3DAixperts/skirt-button-pcb/V1/images/Skirt Button PCB Back.png

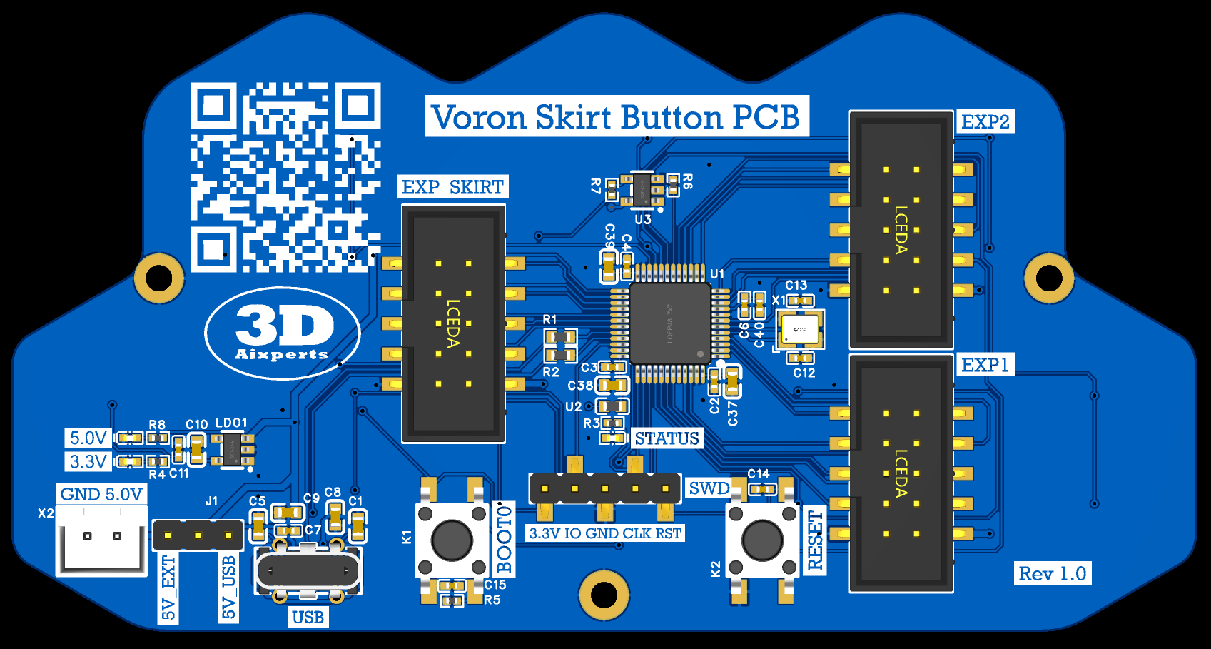
V1/images/Skirt Button PCB Back.png
