3DAixperts/skirt-button-pcb/V1/images/Skirt Button PCB Front.png

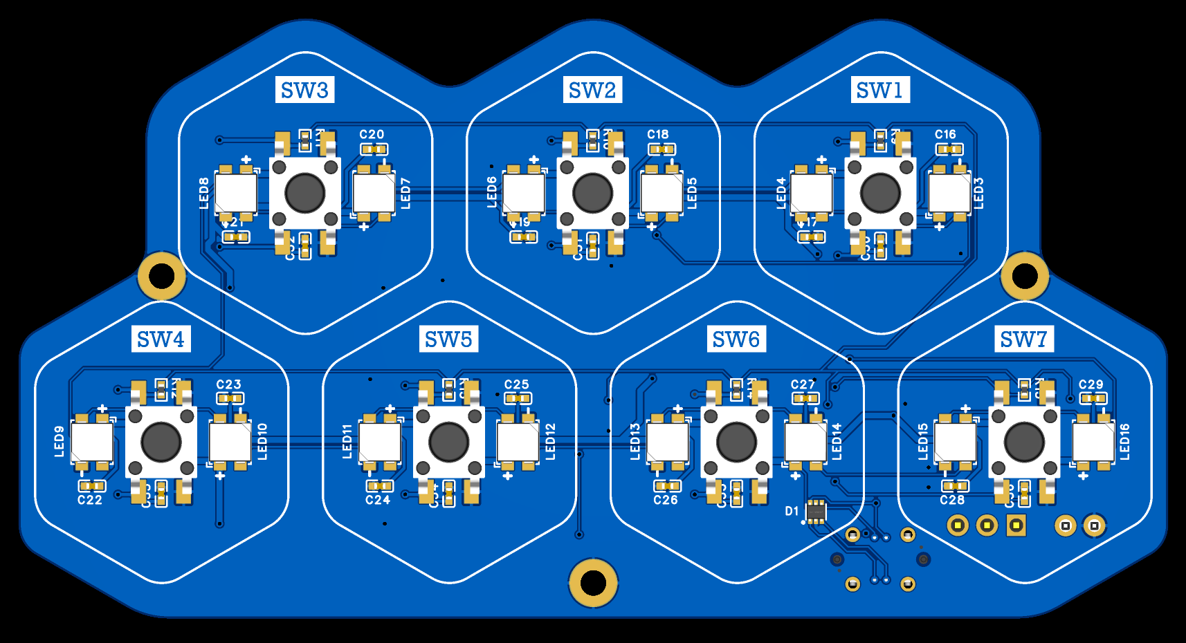
V1/images/Skirt Button PCB Front.png
