3DAixperts/skirt-button-pcb/3D/Skirt_Button_PCB_only_PCB.STEP

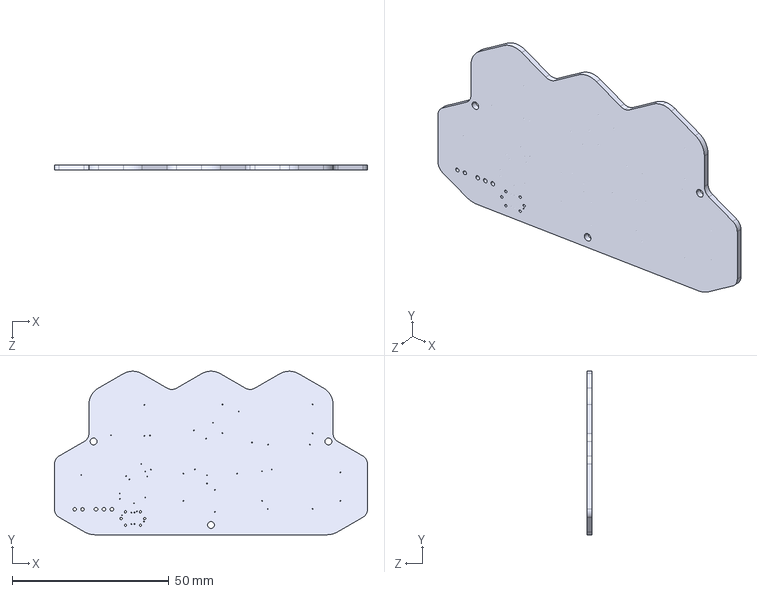
[picture p6: CAD file, 2023-06-12]
3D/Skirt_Button_PCB_only_PCB.STEP
100.0 x 52.3 x 1.60 mm
