3DAixperts/skirt-button-pcb/STEPs/Buttons/regular/single_button_blank.STEP

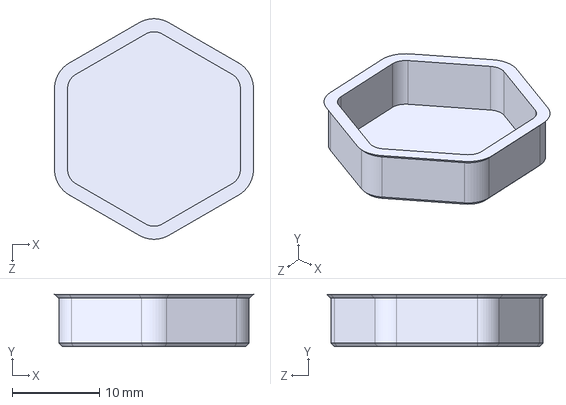
[picture p7: CAD file, 2023-05-26]
STEPs/Buttons/regular/single_button_blank.STEP
22.8 x 6.00 x 25.3 mm
