3DAixperts/skirt-button-pcb/STEPs/Buttons/Trident 250 outer small/button_load_small_250.STEP

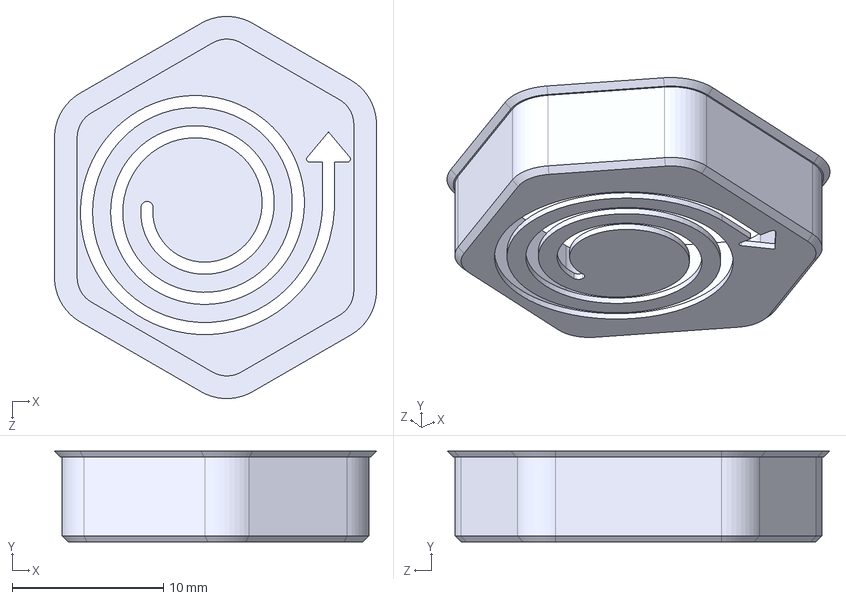
[picture p8: CAD file, 2023-03-20]
STEPs/Buttons/Trident 250 outer small/button_load_small_250.STEP
21.3 x 6.00 x 25.3 mm
