3DAixperts/skirt-button-pcb/STEPs/Trident - Switchwire/250/Left_Front_Skirt_250_Trident_Button_PCB.STEP

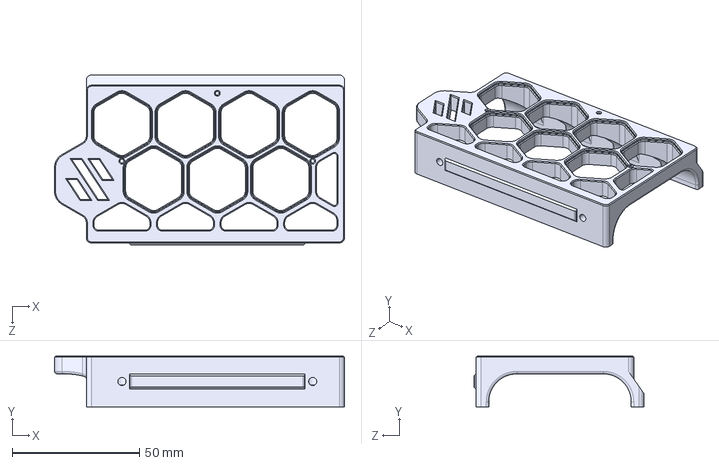
[picture p9: CAD file, 2023-01-08]
STEPs/Trident - Switchwire/250/Left_Front_Skirt_250_Trident_Button_PCB.STEP
114.0 x 20.0 x 66.8 mm
