3DAixperts/skirt-button-pcb/STEPs/Trident - Switchwire/300/Left_Front_Skirt_300_Trident_Button_PCB.STEP

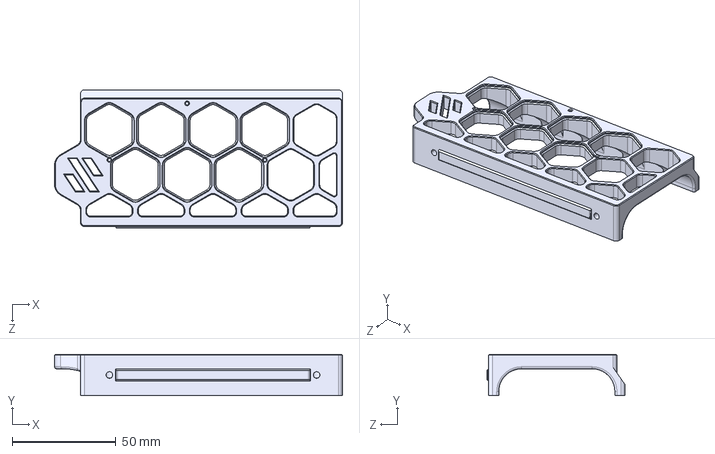
[picture p10: CAD file, 2023-01-08]
STEPs/Trident - Switchwire/300/Left_Front_Skirt_300_Trident_Button_PCB.STEP
139.0 x 20.0 x 66.8 mm
