3DAixperts/skirt-button-pcb/STEPs/Trident - Switchwire/350/Left_Front_Skirt_350_Trident_Button_PCB.STEP

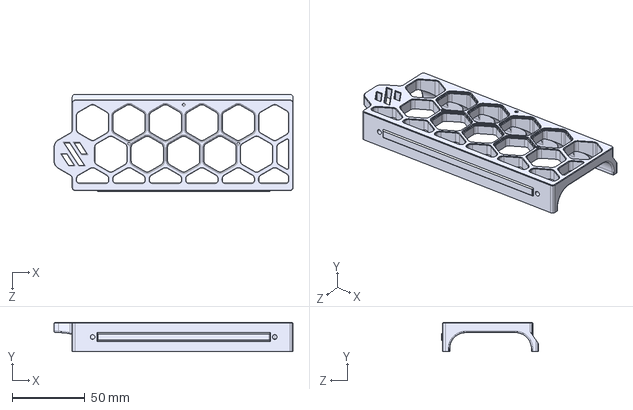
[picture p11: CAD file, 2023-01-08]
STEPs/Trident - Switchwire/350/Left_Front_Skirt_350_Trident_Button_PCB.STEP
164.0 x 20.0 x 66.8 mm
