3DAixperts/skirt-button-pcb/STEPs/V2.4/250/front_skirt_right_250_v2.4_button_PCB.STEP

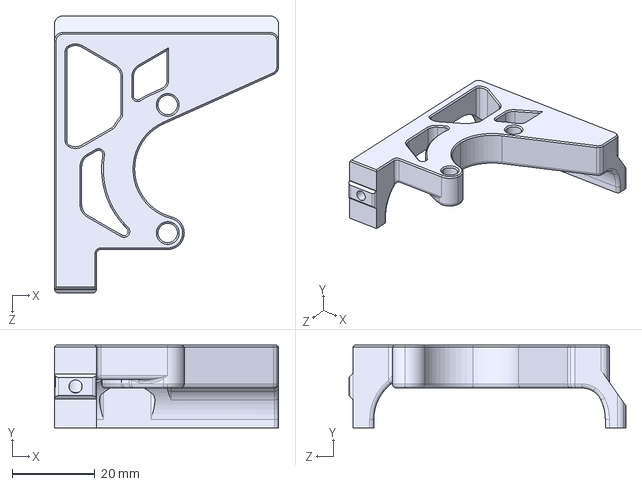
[picture p12: CAD file, 2023-01-08]
STEPs/V2.4/250/front_skirt_right_250_v2.4_button_PCB.STEP
54.2 x 20.0 x 67.0 mm
