3DAixperts/skirt-button-pcb/STEPs/V2.4/300/front_skirt_right_300_v2.4_button_PCB.STEP

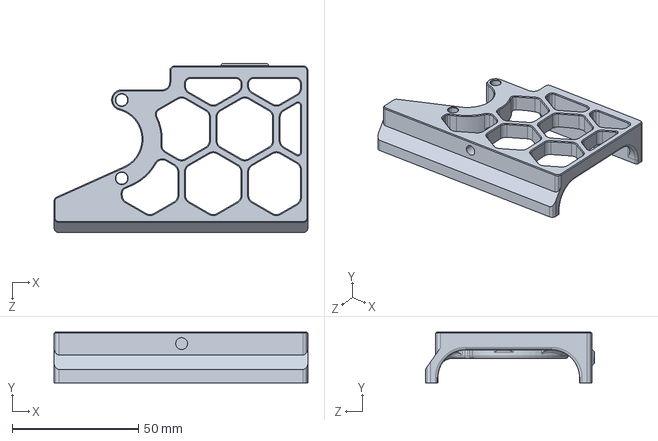
[picture p13: CAD file, 2023-01-08]
STEPs/V2.4/300/front_skirt_right_300_v2.4_button_PCB.STEP
100.5 x 20.0 x 67.0 mm
