3DAixperts/skirt-button-pcb/STEPs/V2.4/350/front_skirt_left_350_v2.4_button_PCB.STEP

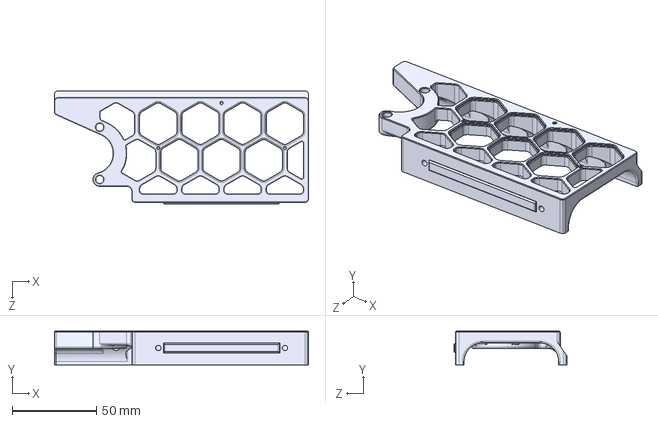
[picture p14: CAD file, 2023-01-08]
STEPs/V2.4/350/front_skirt_left_350_v2.4_button_PCB.STEP
150.5 x 20.0 x 67.0 mm
