3DAixperts/skirt-button-pcb/STEPs/Buttons/regular/button_diffusor.STEP

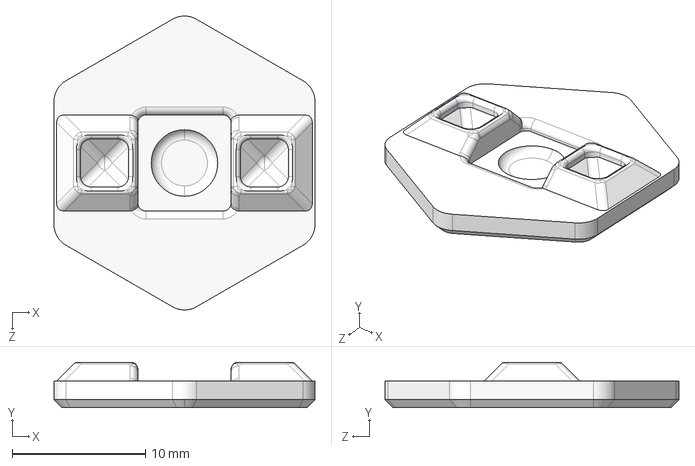
[picture p15: CAD file, 2023-01-29]
STEPs/Buttons/regular/button_diffusor.STEP
19.6 x 3.40 x 22.1 mm
