3DAixperts/skirt-button-pcb/STEPs/Buttons/regular/buttons.STEP

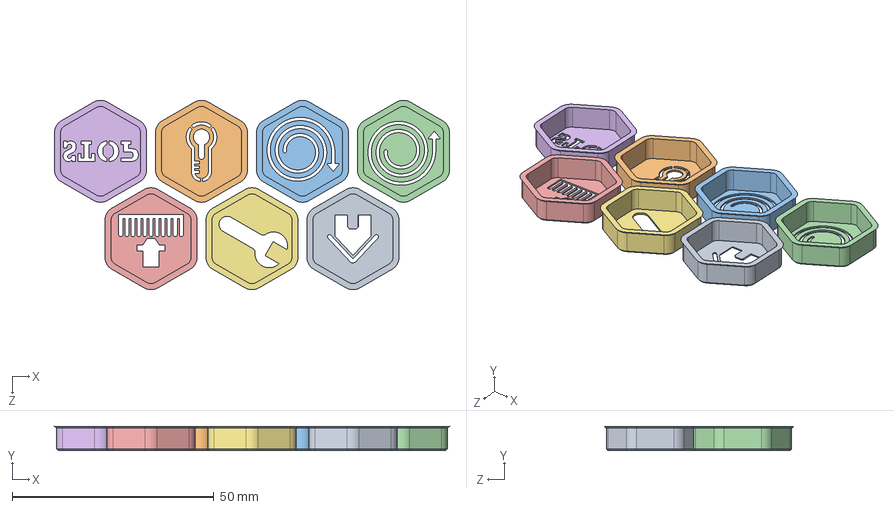
[picture p17: CAD file, 2023-01-08]
STEPs/Buttons/regular/buttons.STEP
97.8 x 6.00 x 46.9 mm
