3DAixperts/skirt-button-pcb/STEPs/Buttons/Trident 250 outer small/diffusor_small_250.STEP

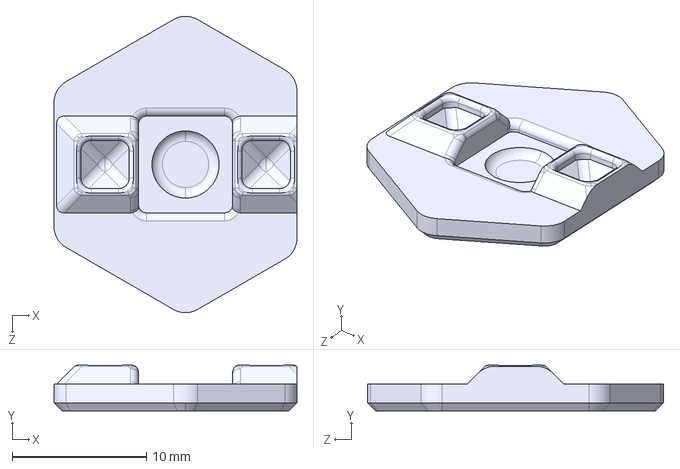
[picture p18: CAD file, 2023-03-19]
STEPs/Buttons/Trident 250 outer small/diffusor_small_250.STEP
18.1 x 3.40 x 22.1 mm
