3DAixperts/skirt-button-pcb/STEPs/V2.0/300/v2.0_skirt_right_300_button_PCB.STEP

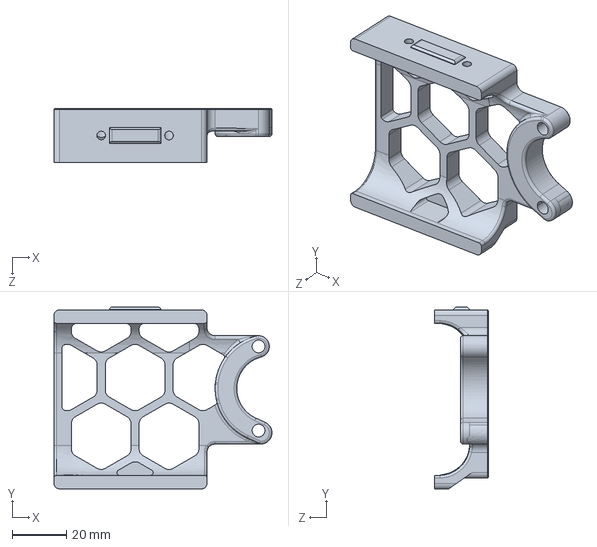
[picture p19: CAD file, 2023-01-20, an earlier design]
STEPs/V2.0/300/v2.0_skirt_right_300_button_PCB.STEP
80.4 x 67.0 x 20.0 mm
