3DAixperts/skirt-button-pcb/STEPs/V2.0/300/v2.0_skirt_left_300_button_PCB.STEP

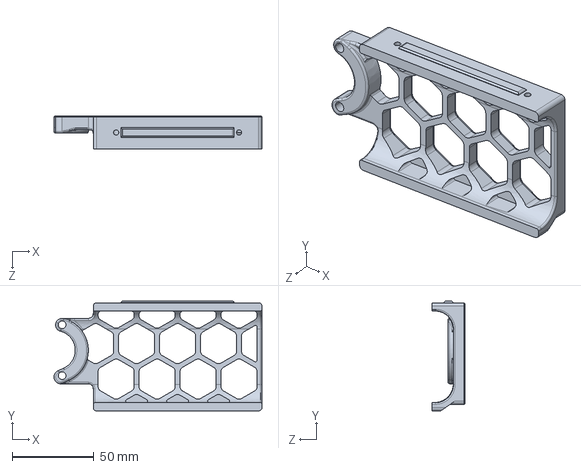
[picture p20: CAD file, 2023-01-20, an earlier design]
STEPs/V2.0/300/v2.0_skirt_left_300_button_PCB.STEP
127.0 x 67.0 x 20.0 mm
