3DAixperts/skirt-button-pcb/(list of files, cad)

Other CAD files:
STLs/Buttons/Regular/buttons.STL
STLs/Buttons/Trident 250 outer small/button_load_small_250.STL
STLs/V2.4/300/front_skirt_right_300_v2.4_button PCB.stl
