3DAixperts/skirt-button-pcb/V1/schematic/SCH_Skirt_Button_PCB_V1.pdf

# GND SWDCLK

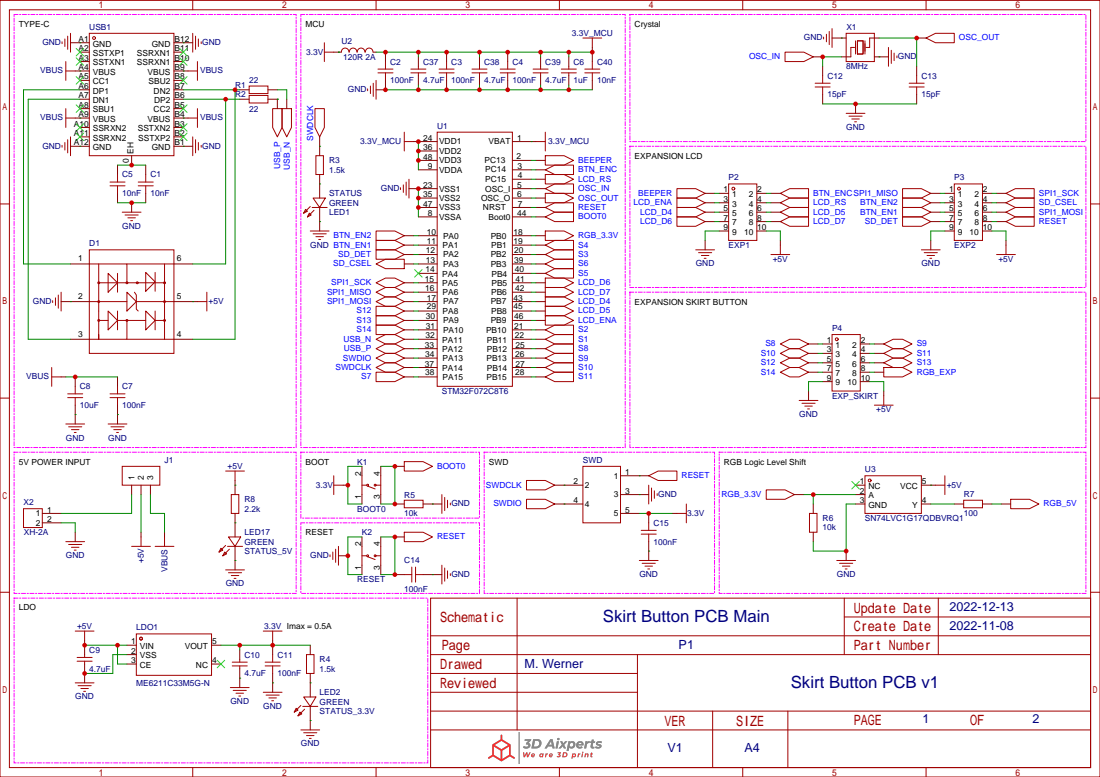
[picture p21: page 1]

RGB Logic Level Shift

GND
2022-11-08 Skirt Button PCB Main

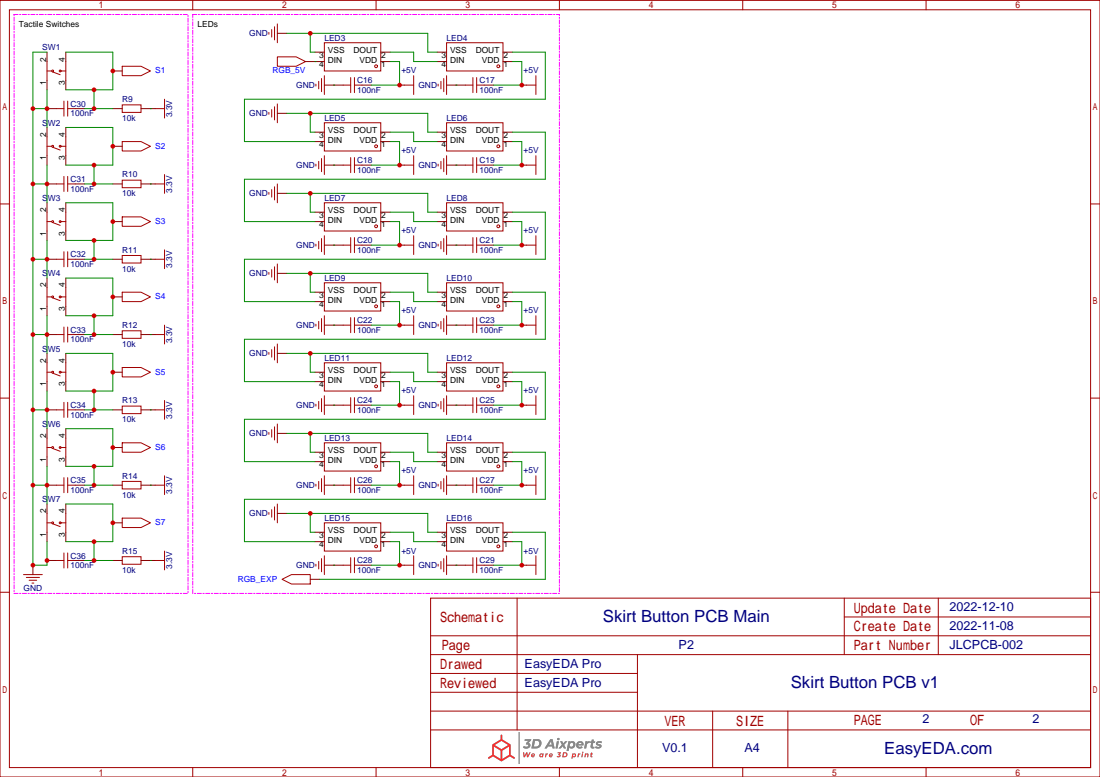
[picture p22: page 2]

2022-11-08 Skirt Button PCB Main
