3DAixperts/skirt-button-pcb/Manual/Voron Skirt Button PCB Klipper Firmware.pdf

# Voron Skirt Button PCB Klipper Firmware

## Compile Firmware

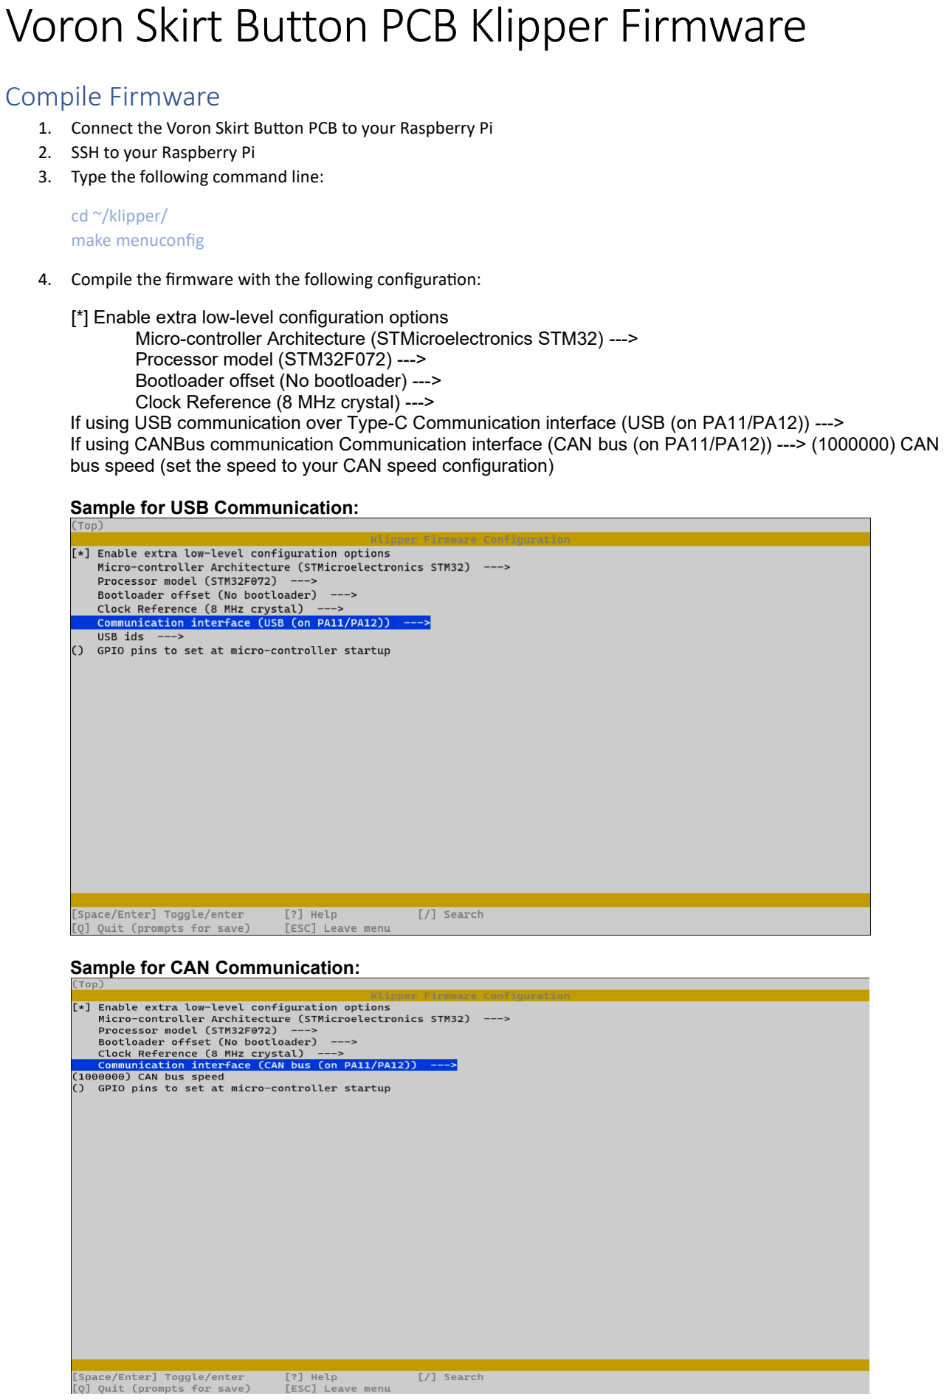
[picture p23: page 1]

1. Connect the Voron Skirt Button PCB to your Raspberry Pi
2. SSH to your Raspberry Pi
3. Type the following command line:

cd ~/klipper/
make menuconfig
4. Compile the firmware with the following configuration:

[*] Enable extra low-level configuration options
Micro-controller Architecture (STMicroelectronics STM32) ---> Processor model (STM32F072) --->
Bootloader offset (No bootloader) --->
Clock Reference (8 MHz crystal) --->
If using USB communication over Type-C Communication interface (USB (on PA11/PA12)) --->
If using CANBus communication Communication interface (CAN bus (on PA11/PA12)) ---> (1000000) CAN bus speed (set the speed to your CAN speed configuration)

Sample for USB Communication:

Sample for CAN Communication:

5. When completed the configuration selection, type „q“ to exit the configuration interface. Select „Yes“ when asked wheter to save the configuration.
6. Enter „make clean“ to remove older firmware compilation files.
7. Enter „make“ to compile the new firmware. The firmware file „klipper.bin“ would be located in home/pi/klipper/out

## Updating Firmware

1. Make sure the Skirt Button PCB is connected to your Raspberry Pi
2. Press the „BOOT0“ button, then press and release the „RESET“ button to entert he DFU mode.

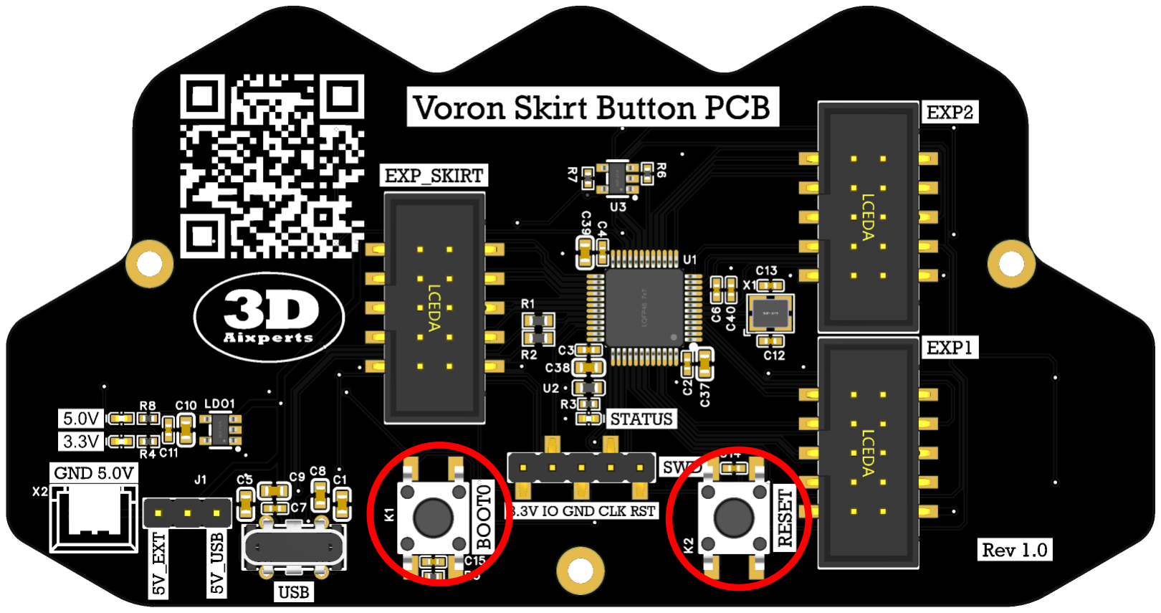
[picture p24: figure]

3. Make sure that the „STATUS“ LED is green. This indicates that the Board is in DFU mode

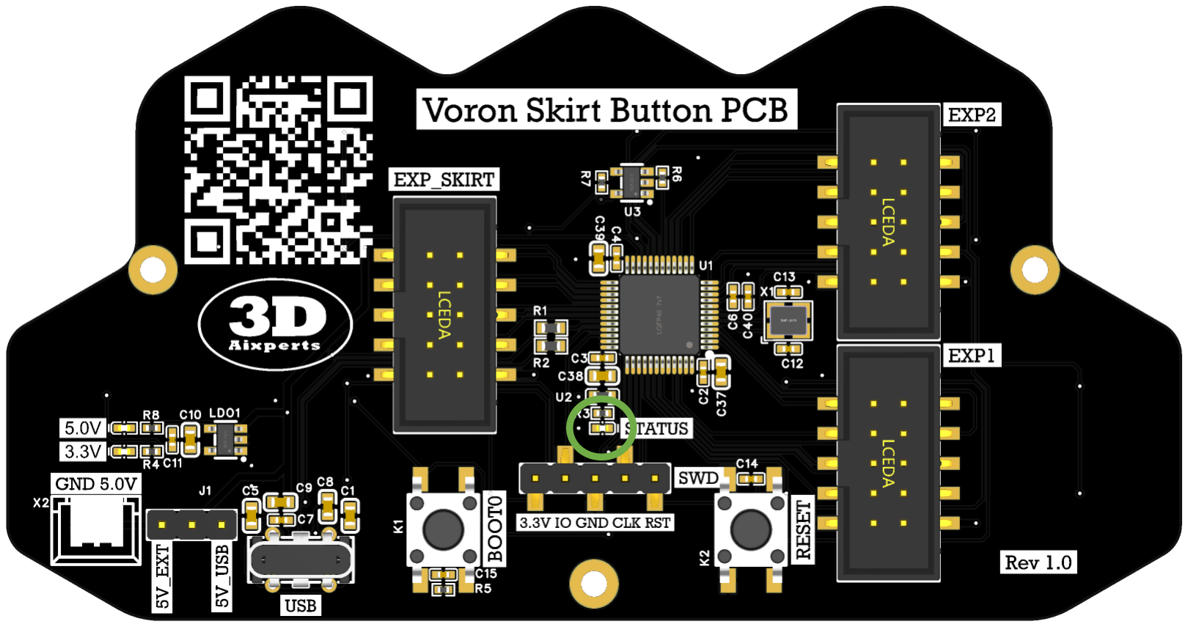
[picture p25: figure]

4. Type „lsusb“ in the SSH terminal command line to query the ID oft he DFU device
5. Type „make flash FLASH_DEVICE=0483:df11“ to download the firmware to the board (Notice: Replace 0483:df11 with the actual ID oft he DFU device queried in the previous step).

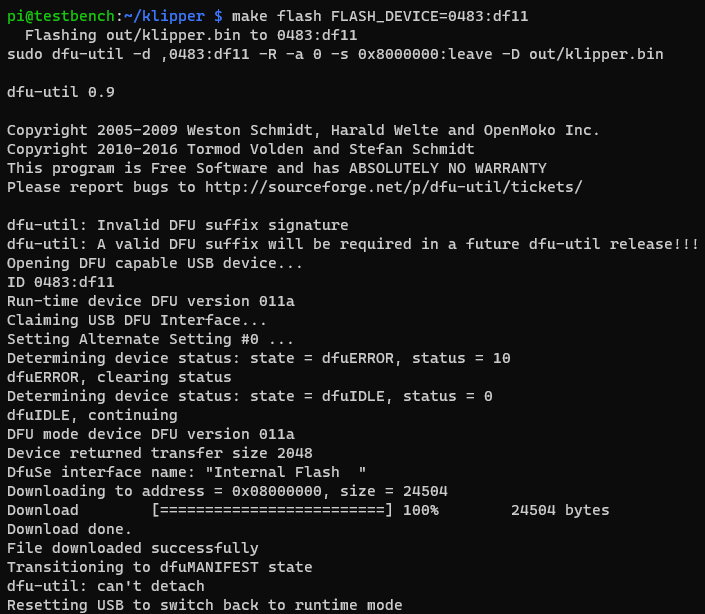
[picture p26: figure]

6. Type „ls /dev/serial/by-id/“ to query about the serial ID of the device when finished downloading firmware (The serial ID will only exists when communicating via USB. Ignore this step when communicating via CAN Bus).

Enter the result of the command in the skirt_button_pcb.cfg

Note: Your ID may vary
