3DAixperts/skirt-button-pcb/(threads)

Thread 4 (2023-09-03):

screw size for mounting

BlackNet, 2023-09-03:
Have one of these boards.  What size screws does it take to mount to the printed skirt frame?

Markus-1984, 2023-09-03:
The screws are M2x6 self tapping and included.

3DAixperts, 2023-09-03:
The screws are M2x6 self tapping and are included in the set.

BlackNet, 2023-09-04:
ok, thanks.  didn't see it listed anywhere and was not sure what size.  will close this and thanks for the reply and info.

Closed 2023-09-04.

Thread 5 (2023-09-07):

The skirt STLs for 300 V2.4 are too big to fit the printer

voidtrance, 2023-09-07:
The skirt STLs that are in the repository are too big to fit a 300 V2.4. The default skirt left (left, for example) is 125mm long, which the PCB skirt is 150mm long.

Left PCB Skirt:
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

Left Voron 300 Skirt:
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

voidtrance, 2023-09-07:
The GitHub page does not have this info but the product page linked on the front GitHub page says that the display needs to be moved on 250 and 300 printers.

Closed 2023-09-07.

Thread 6 (2023-09-09):

CAN bus support, but no transceiver nor header?

MaffooClock, 2023-09-09:
I see that CAN bus support is offered, but I don't see a header for the connection.

I see [the manual](https://github.com/3DAixperts/skirt-button-pcb/blob/1b6d5c83fcdb094d41ca2357ecc0be1030fd60db/Manual/Voron%20Skirt%20Button%20PCB%20Klipper%20Firmware.pdf) says to use the same pins as USB for CAN bus connection, so are we meant to cut into a USB-C cable to get the data lines?

But connecting to PA11/PA12 for CAN bus won't do any good anyway since there's isn't a transceiver for converting FDCAN TX/RX to differential CAN high/low, and no 120Ω termination option (resistor + jumper).

Or am I being dumb and completely missing the point?

MaffooClock, 2023-09-09:
> I see the manual says to use the same pins as USB for CAN bus connection...

A thought just occurred to me: maybe the guide was meant to specify the "USB to CAN bridge (USB on PA11/PA12)" option in Klipper's menuconfig (instead of "CAN bus on PA11/PA12"), but that kinda doesn't make sense, since we'd be using the USB connection anyway, plus no physical connectivity for adding other nodes to the CAN bus, so may as well just stick with classic USB.

3DAixperts, 2023-09-15:
The PCB is designed to work with CAN bus with the U2C/UTOC boards. These boards are equipped with a USB connector for boards like the EBB36 with CAN without transceiver. So you can configure the skirt button PCB like the manual says and connect it to the U2C or UTOC CAN PCB.
