3DAixperts/skirt-button-pcb/(commit log)

2023-01-08 Add files via upload
    STEP and STL files for skirts and buttons added
    [Left_Front_Skirt_250_Trident_Button_PCB.STEP, Left_Front_Skirt_300_Trident_Button_PCB.STEP, Left_Front_Skirt_350_Trident_Button_PCB.STEP, buttons.STL, front_skirt_left_250_v2.4_button_PCB.STEP, front_skirt_left_300_v2.4_button_PCB.STEP, front_skirt_left_350_v2.4_button_PCB.STEP, front_skirt_right_250_v2.4_button_PCB.STEP]
2023-01-13 Update skirt_button_pcb.cfg
    disabled display_group: __voron_display
    This is from Ellis display tweaks and don´t work without his config.
    [skirt_button_pcb.cfg]
2023-01-13 Update skirt_button_pcb.cfg
    Commented out the display section to prevent error messages if the 12864_mini display is connected to the mainboard instead of skirt button pcb
    [skirt_button_pcb.cfg]
2023-01-19 Update skirt_button_pcb.cfg
    - Added information about the macros I used
    [skirt_button_pcb.cfg]
2023-01-20 Add files via upload
    Added modified skirts for V2.0 300mm
2023-01-20 Add files via upload
    corrected Folder name to Trident - Switchwire
2023-03-19 Add files via upload
    smal outer button & diffusor for Trident 250 skirts
    [button_load_small_250.STEP, diffusor_small_250.STEP]
2023-05-26 Add files via upload
    Added single Button for easier mods
    [single_button_blank.STEP]
2023-06-12 Added 3D Files of the PCB
    [Skirt_Button_PCB_only_PCB.STEP]
